kalse3/Wine-Fermentation-Valve-Control/Images/img3.jpeg

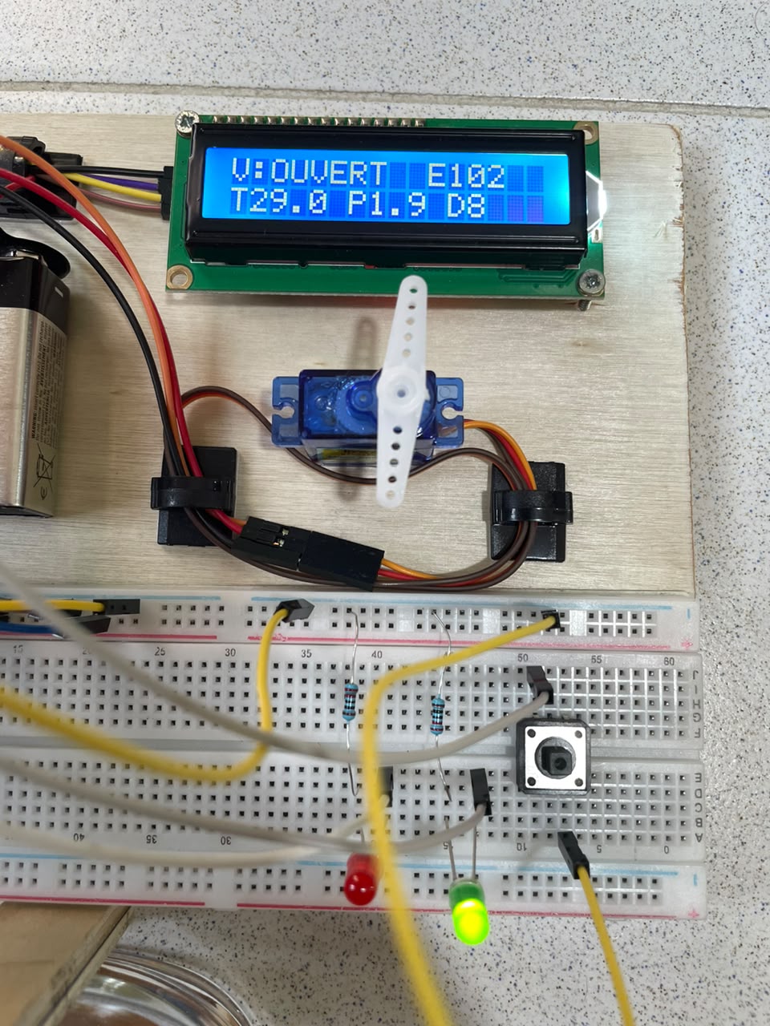
Images/img3.jpeg
