kalse3/Wine-Fermentation-Valve-Control/Images/img4.jpeg

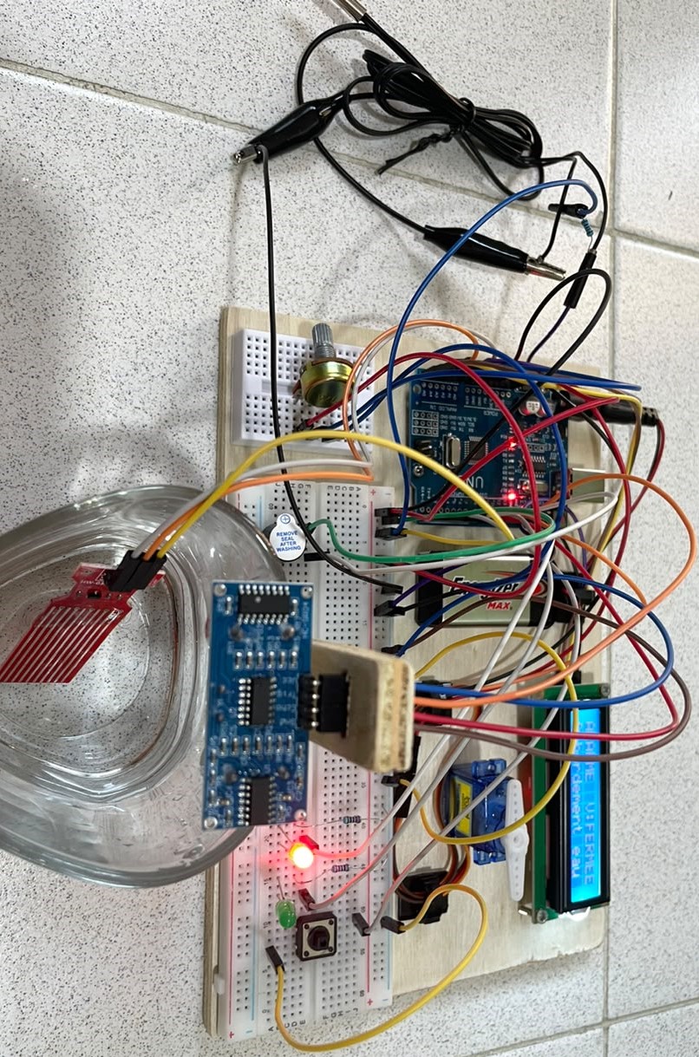
Images/img4.jpeg
