kalse3/Wine-Fermentation-Valve-Control/README.md

# Wine-Fermentation-Valve-Control
Automated valve control system for a wine fermentation tank using Arduino Uno, integrating instrumentation, safety logic, and actuator selection for industrial process automation.
