kalse3/Wine-Fermentation-Valve-Control/Images/img1.jpeg

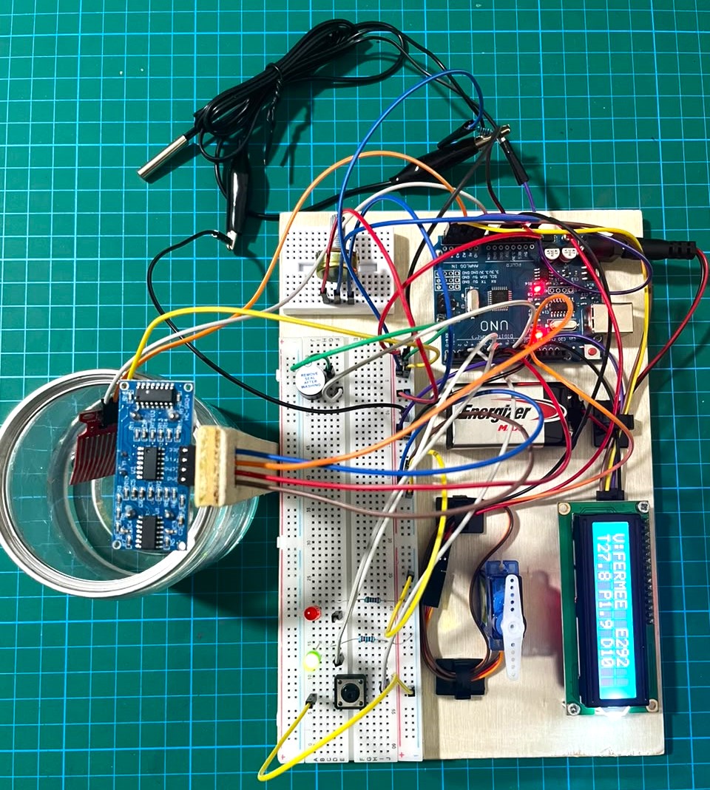
Images/img1.jpeg
