kalse3/Wine-Fermentation-Valve-Control/Images/img5.jpeg

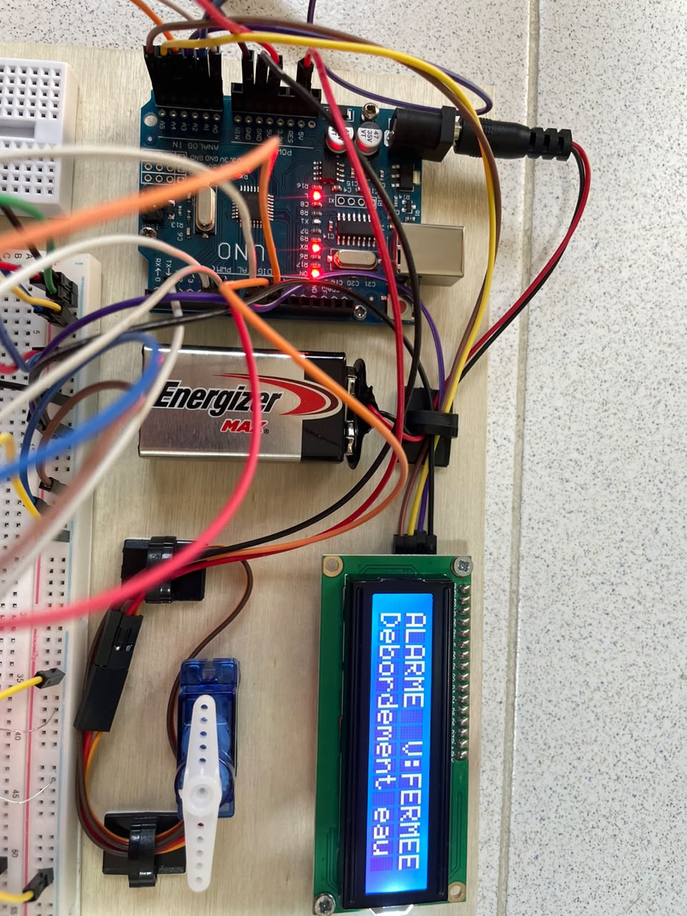
Images/img5.jpeg
