kalse3/Wine-Fermentation-Valve-Control/Schematics/Valve Automation Circuit Diagram.png

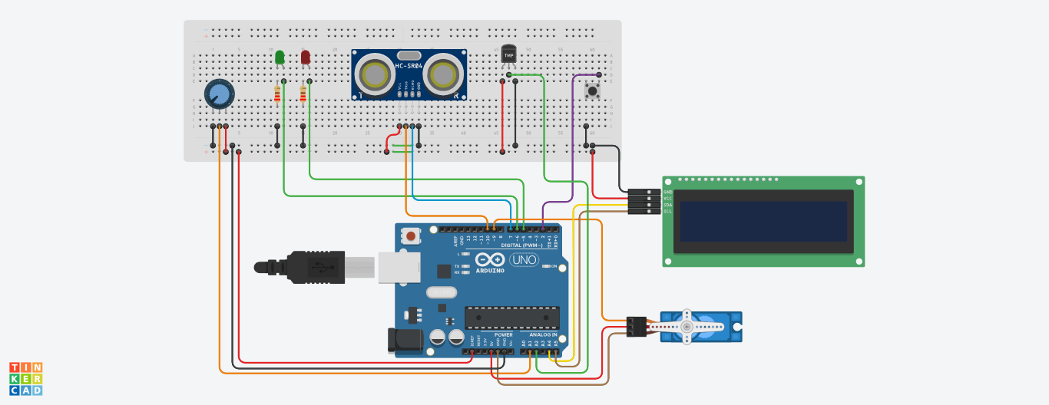
Schematics/Valve Automation Circuit Diagram.png
