kalse3/Wine-Fermentation-Valve-Control/Schematics/Valve Automation Schematic View.pdf

A

1 | 2 | 3 | 4 | 5 | 6

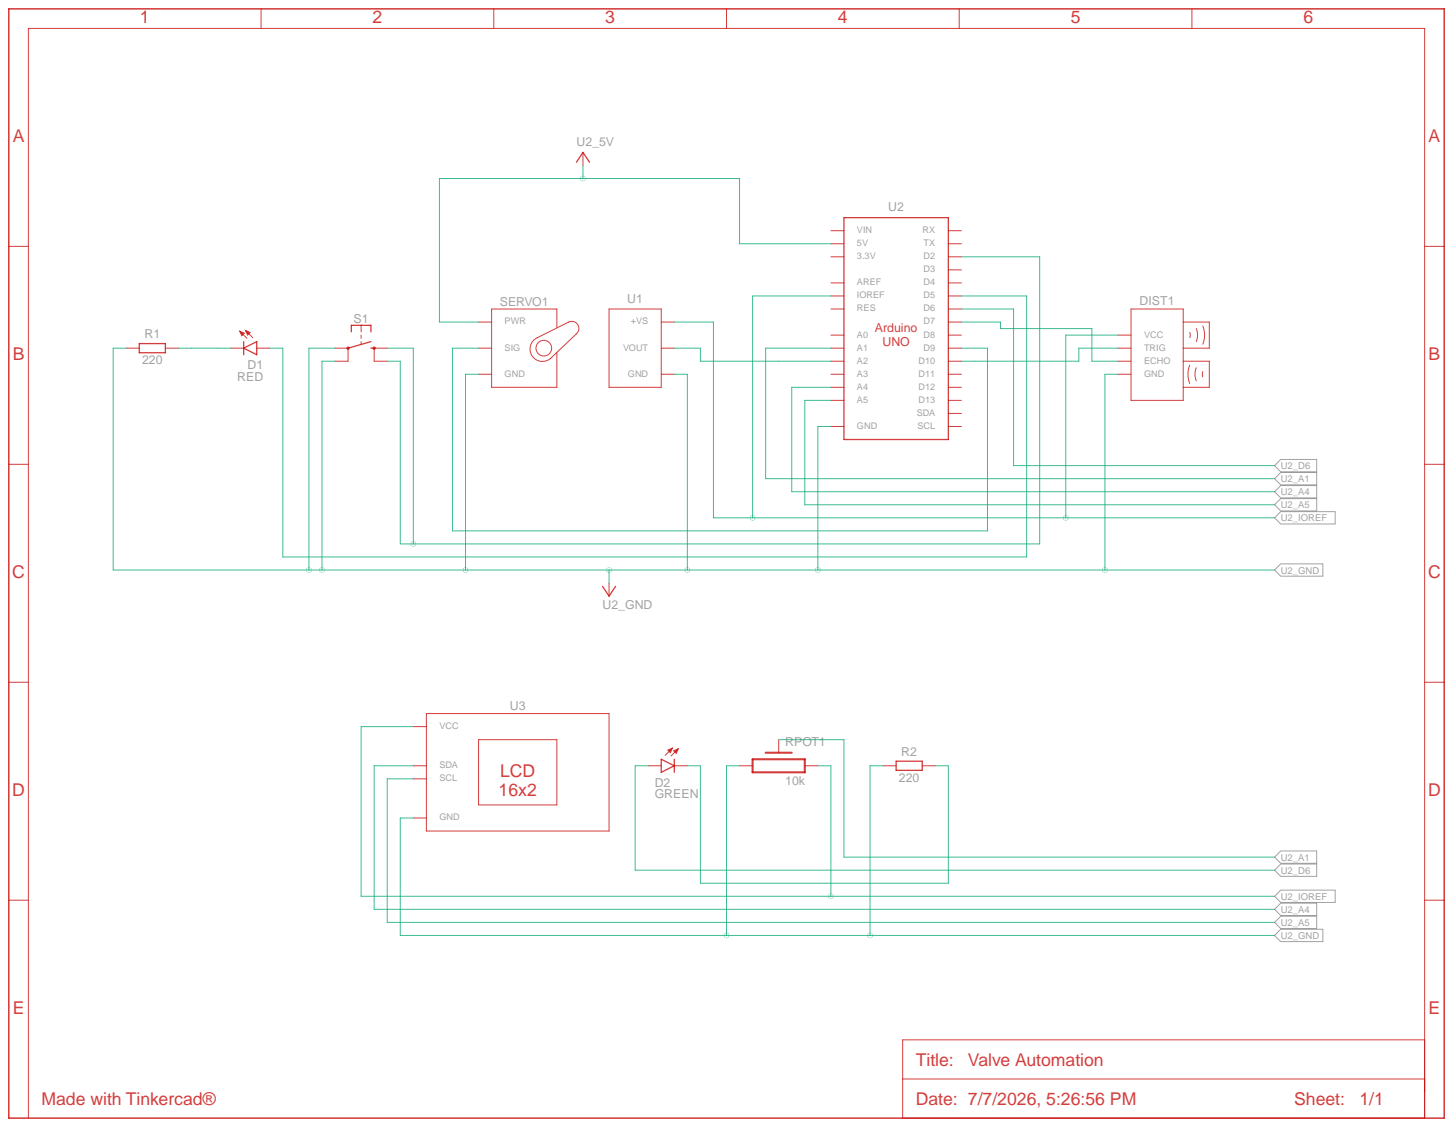
[picture p16: page 1]
