kalse3/Wine-Fermentation-Valve-Control/(commit log)

2026-07-07 Added project flowchart
2026-07-07 Add schematic files
2026-07-07 Add project's Arduino code
2026-07-07 Add prototype images
